RyanT2004/MEE342-Group-9/README.md

<h1 align="center">Shift Happens</h1>

<div align="center">
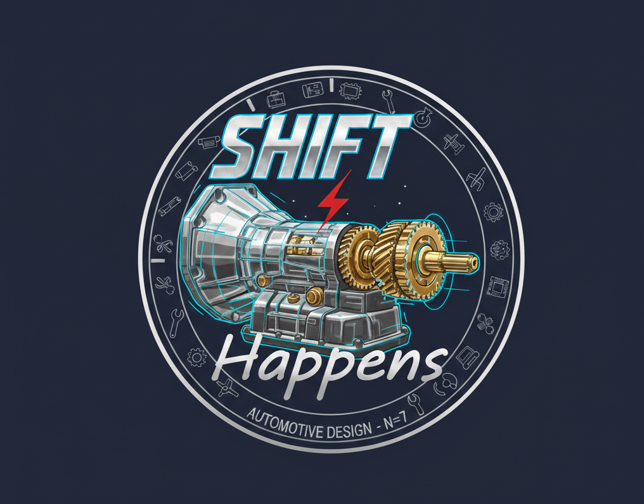
[picture p1: images/TeamLogo.png]
  
</div>

## Content
* [CAD](cad)

* [Analysis](analysis)

* [Images](images)

* [Videos](videos)

## Phase Reports
* [Phase 1](phase1/phase1.md)
* [Phase 2](phase2/phase2.md)
* [Phase 3](phase3/phase3.md)
