RyanT2004/MEE342-Group-9/images/README.md

images used in the report (diagrams, CAD screenshots, photos, etc.).
