RyanT2004/MEE342-Group-9/cad/README.md

exported CAD files in neutral formats (STEP, STL).
