RyanT2004/MEE342-Group-9/phase3/phase3video.md

Phase 3 Video Demonstrating Our Built Prototype
---
[Phase 3 Video](https://youtu.be/IrrpojLI-mE)
