RyanT2004/MEE342-Group-9/phase2/phase2video.md

Phase 2 Video Describing Our Model and Assembly
---
[Phase 2 Video](https://www.youtube.com/watch?v=oqWOlrIUnAM)
