RyanT2004/MEE342-Group-9/analysis/Calculation Images/AGMA Geometry Factor for Bending.png

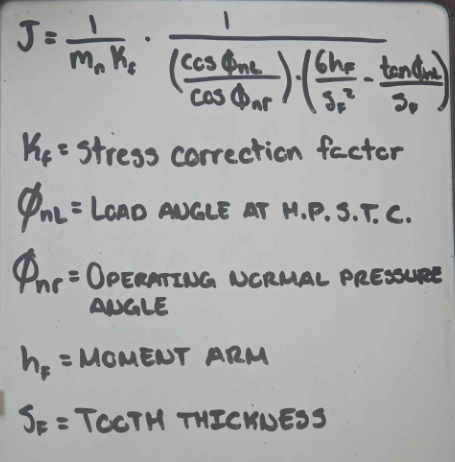
analysis/Calculation Images/AGMA Geometry Factor for Bending.png
