RyanT2004/MEE342-Group-9/analysis/Calculation Images/AGMA Standards Calculations 2.png

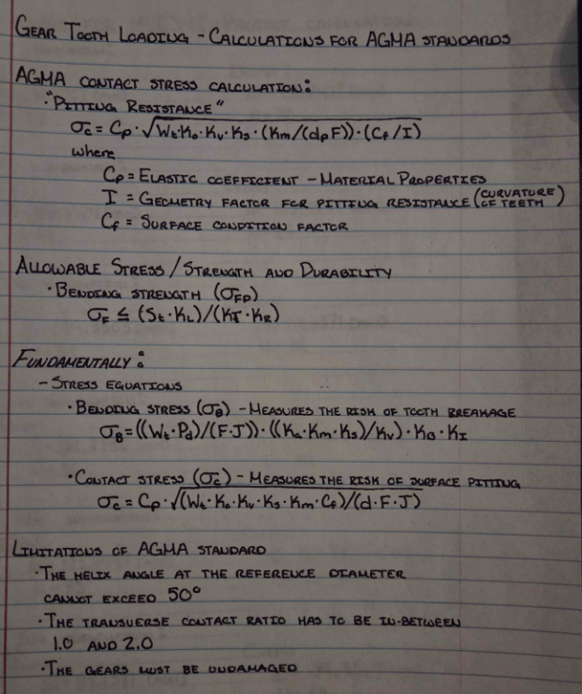
analysis/Calculation Images/AGMA Standards Calculations 2.png
