RyanT2004/MEE342-Group-9/analysis/Calculation Images/AGMA Standards Calculations.png

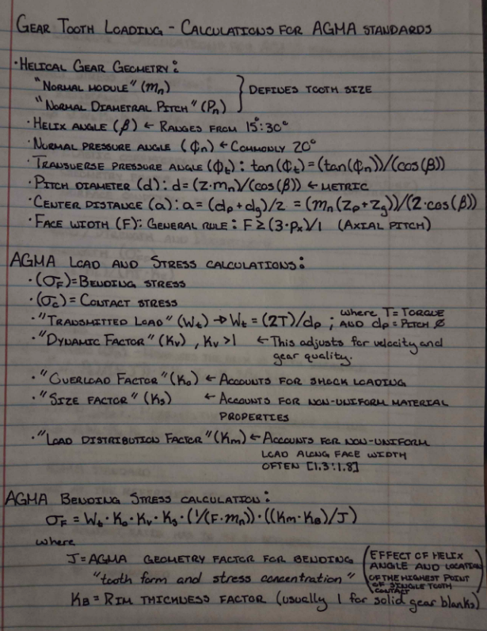
analysis/Calculation Images/AGMA Standards Calculations.png
