RyanT2004/MEE342-Group-9/analysis/Calculation Images/Gear Assumption & Explanation.png

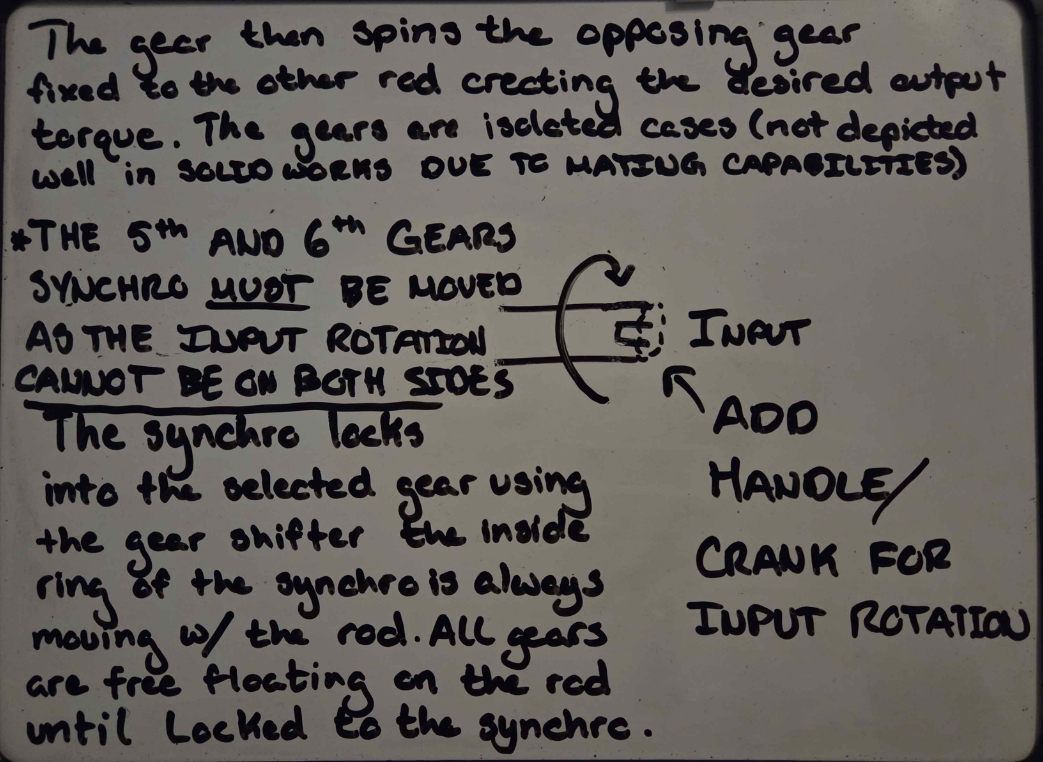
analysis/Calculation Images/Gear Assumption & Explanation.png
