RyanT2004/MEE342-Group-9/analysis/Calculation Images/Gear Ratio Calculation.png

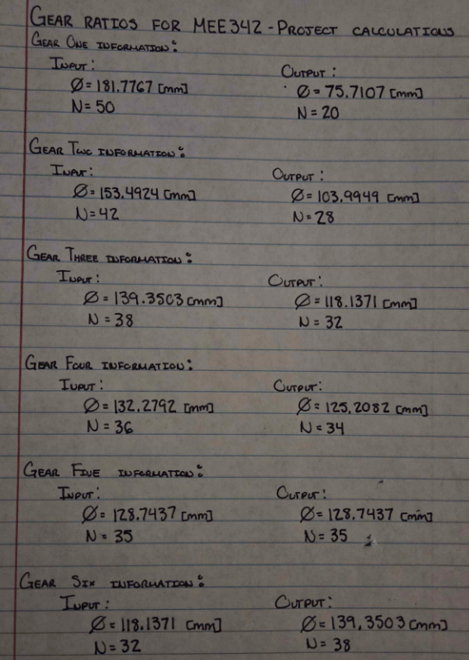
analysis/Calculation Images/Gear Ratio Calculation.png
