RyanT2004/MEE342-Group-9/analysis/Calculation Images/Torque Calculations.png

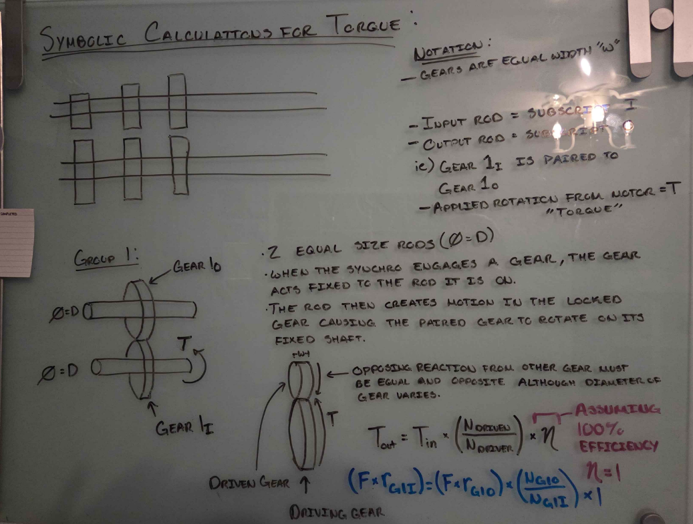
analysis/Calculation Images/Torque Calculations.png
