RyanT2004/MEE342-Group-9/analysis/Stress and Loading Image.png

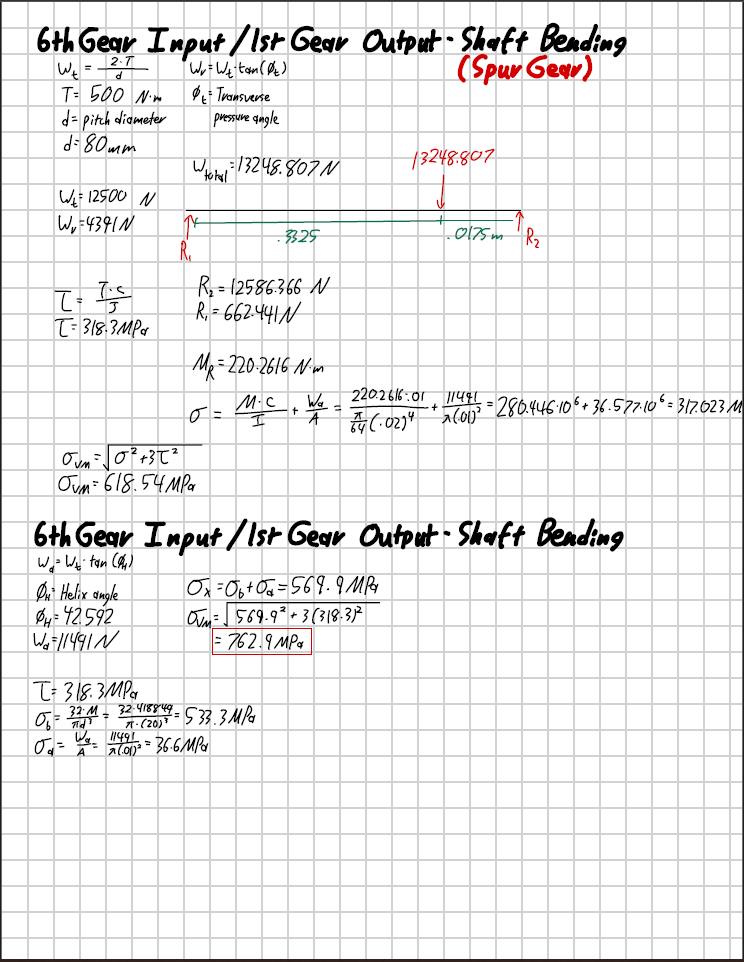
analysis/Stress and Loading Image.png
