RyanT2004/MEE342-Group-9/images/FBD.png

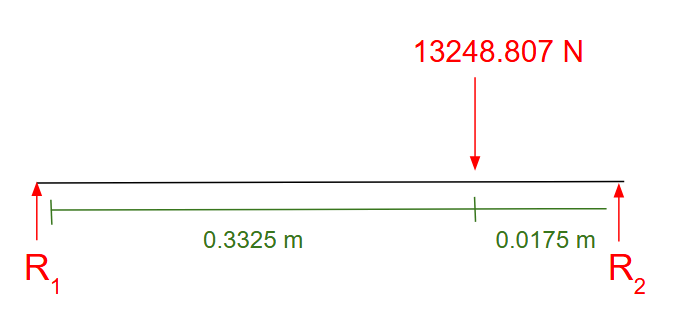
images/FBD.png
