RyanT2004/MEE342-Group-9/images/Transmission Layout.png

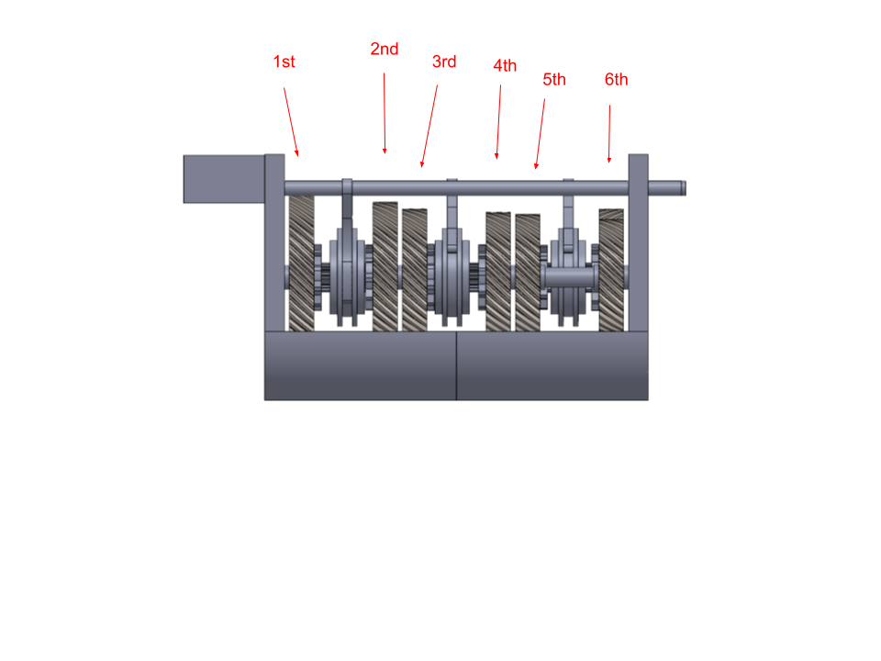
images/Transmission Layout.png
