RyanT2004/MEE342-Group-9/cad/6-Speed Manual Transmission/TransAssembly.SLDASM

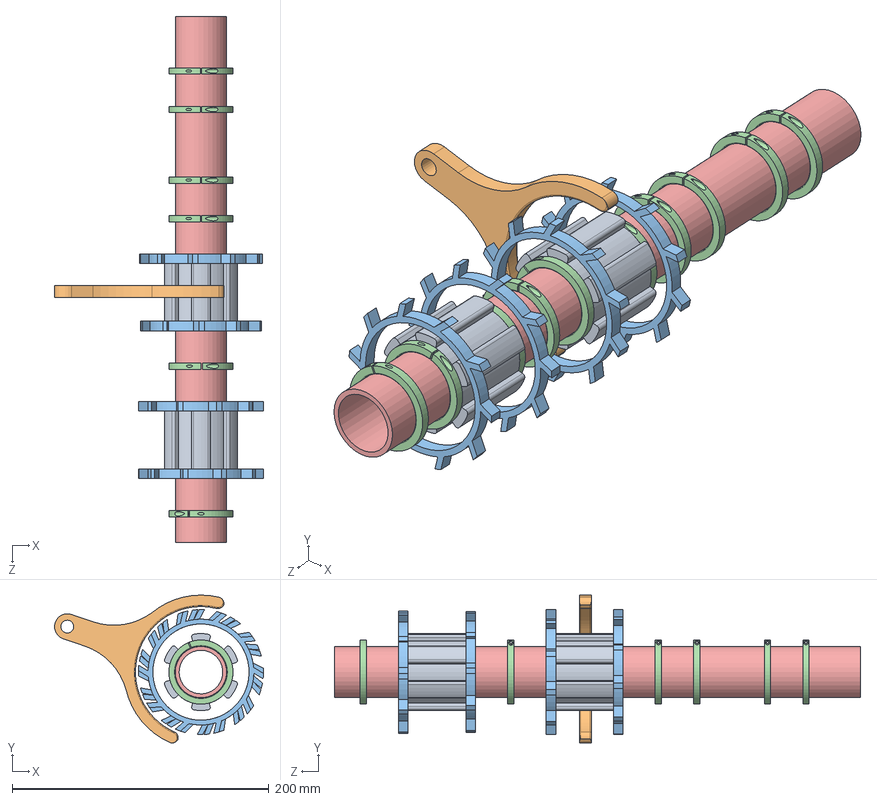
[picture p54: CAD file, 2026-05-01]
cad/6-Speed Manual Transmission/TransAssembly.SLDASM
162.9 x 115.2 x 410.0 mm
Shaft
ShaftRing x 10
gearThing x 4
Fork_Coupler
New_SynchroSleeve x 2
