RyanT2004/MEE342-Group-9/cad/6-Speed Manual Transmission/To Print/New_Full_synchro.SLDASM

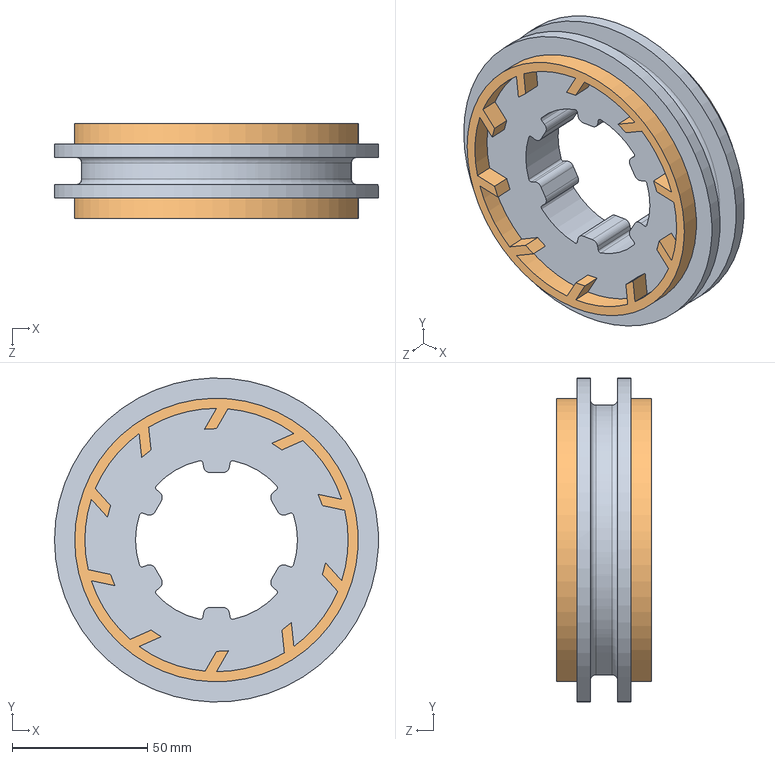
[picture p55: CAD file, 2026-05-01]
cad/6-Speed Manual Transmission/To Print/New_Full_synchro.SLDASM
120.0 x 119.9 x 35.0 mm
GearCoupler x 2
synchro_New
