RyanT2004/MEE342-Group-9/cad/6-Speed Manual Transmission/FULL_ASSEMBLY_WH.SLDASM

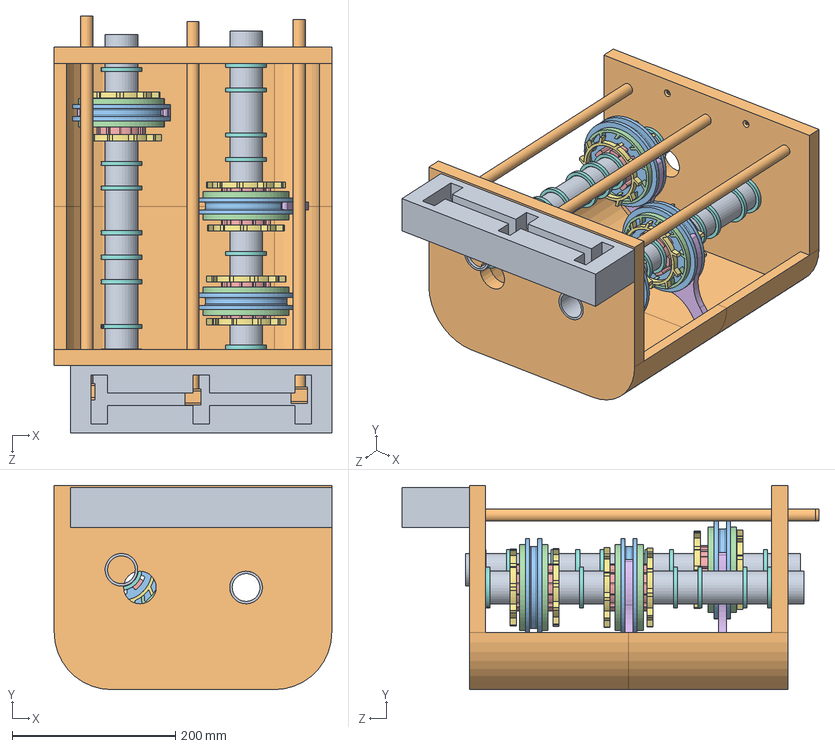
[picture p56: CAD file, 2026-05-01]
cad/6-Speed Manual Transmission/FULL_ASSEMBLY_WH.SLDASM
340.0 x 250.0 x 510.7 mm
Housing_Test x 2
Shaft x 2
ShaftRing x 20
gearThing x 6
Fork_Coupler x 2
New_SynchroSleeve x 3
GearCoupler x 6
synchro_New x 3
Shift_Cradle_Generic x 3
ShiftBox
