RyanT2004/MEE342-Group-9/cad/6-Speed Manual Transmission/Input_Assembly.SLDASM

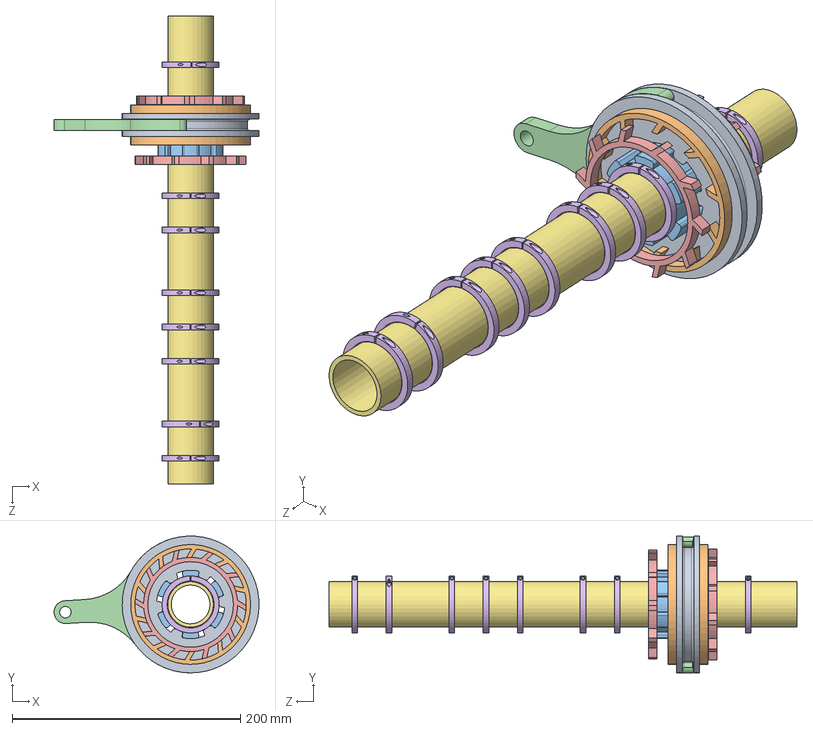
[picture p57: CAD file, 2026-05-01]
cad/6-Speed Manual Transmission/Input_Assembly.SLDASM
179.7 x 119.9 x 410.0 mm
Shaft
ShaftRing x 10
gearThing x 2
Fork_Coupler
New_SynchroSleeve
GearCoupler x 2
synchro_New
