RyanT2004/MEE342-Group-9/cad/6-Speed Manual Transmission/INPUT_gears_Updated/4th_Input_Updated.SLDPRT

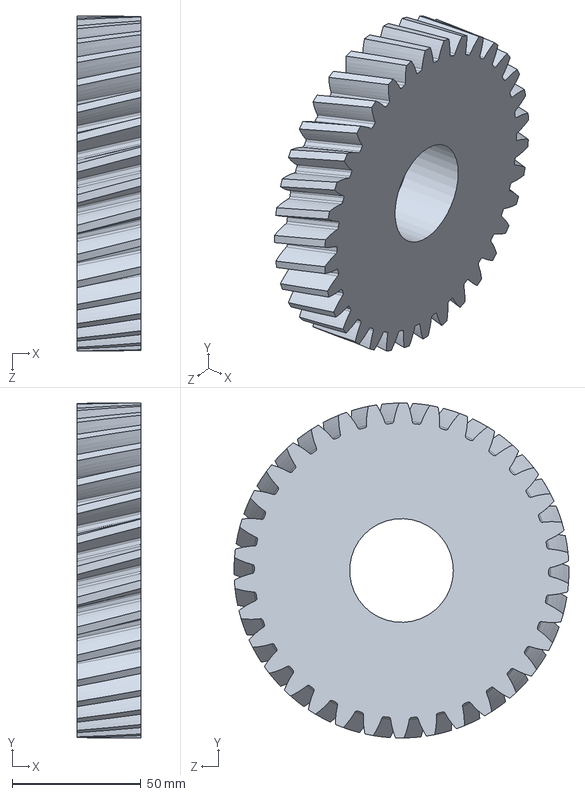
[picture p58: CAD file, 2026-05-01]
cad/6-Speed Manual Transmission/INPUT_gears_Updated/4th_Input_Updated.SLDPRT
25.0 x 130.2 x 130.2 mm
