RyanT2004/MEE342-Group-9/cad/6-Speed Manual Transmission/OUTPUT_gears_Updated/6th_Updated_Output.SLDPRT

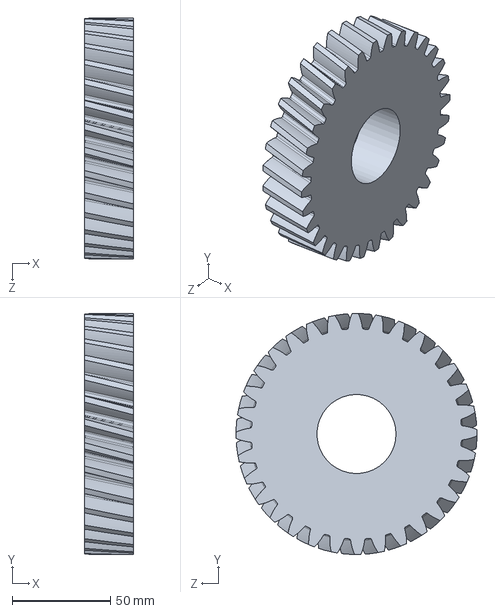
[picture p59: CAD file, 2026-05-01]
cad/6-Speed Manual Transmission/OUTPUT_gears_Updated/6th_Updated_Output.SLDPRT
25.0 x 122.9 x 122.9 mm
