RyanT2004/MEE342-Group-9/cad/6-Speed Manual Transmission/ShaftRing.SLDPRT

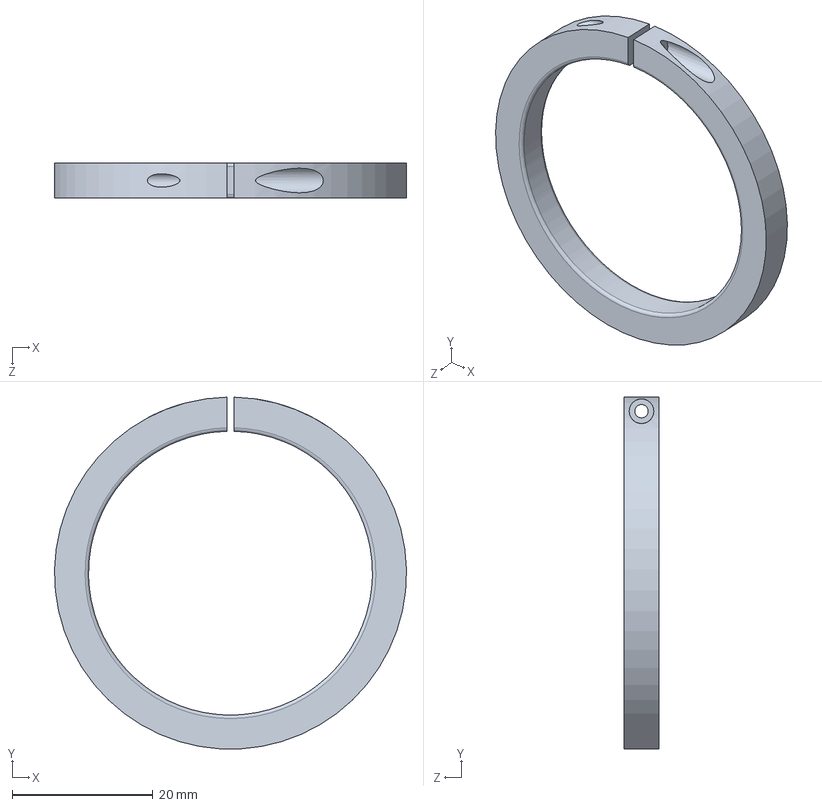
[picture p60: CAD file, 2026-05-01]
cad/6-Speed Manual Transmission/ShaftRing.SLDPRT
50.0 x 50.0 x 5.00 mm
