RyanT2004/MEE342-Group-9/cad/6-Speed Manual Transmission/Shift_Cradles/Shift_Cradle_Generic.SLDPRT

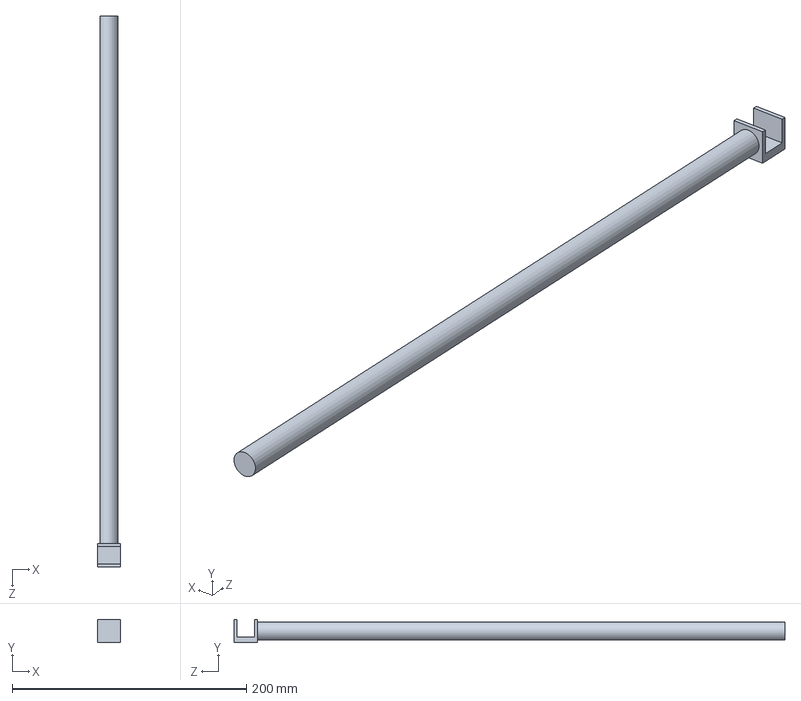
[picture p61: CAD file, 2026-05-01]
cad/6-Speed Manual Transmission/Shift_Cradles/Shift_Cradle_Generic.SLDPRT
20.0 x 20.0 x 470.0 mm
