RyanT2004/MEE342-Group-9/cad/6-Speed Manual Transmission/To Print/New_SynchroSleeve.SLDPRT

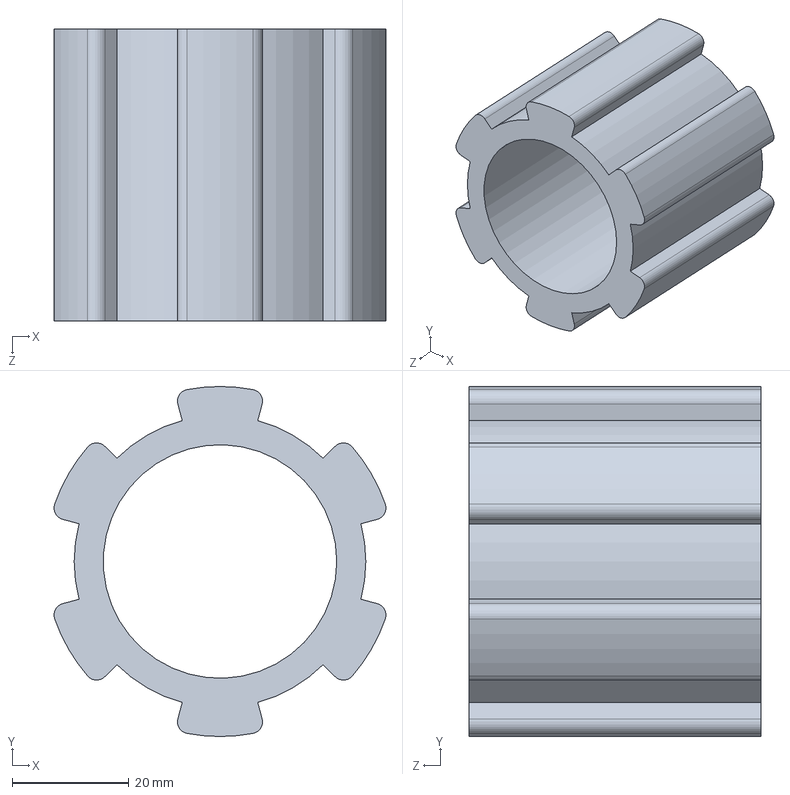
[picture p62: CAD file, 2026-05-01]
cad/6-Speed Manual Transmission/To Print/New_SynchroSleeve.SLDPRT
56.9 x 60.0 x 50.0 mm
