RyanT2004/MEE342-Group-9/cad/6-Speed Manual Transmission/Input_Gear_With_Synchro/Input_Gear6_Part_Combine.SLDPRT

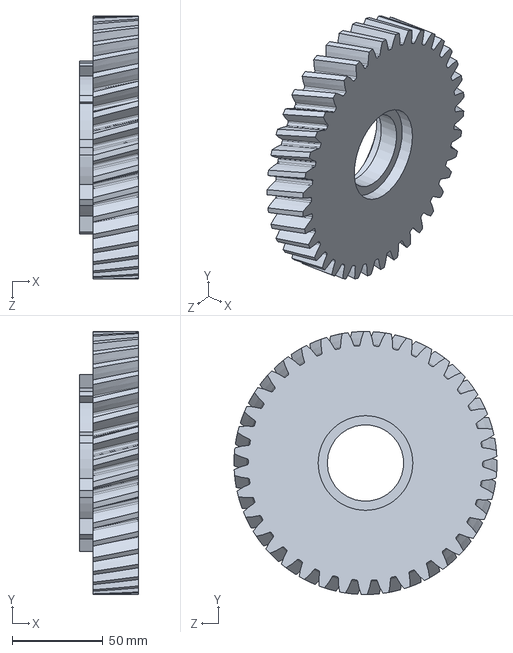
[picture p63: CAD file, 2026-05-01]
cad/6-Speed Manual Transmission/Input_Gear_With_Synchro/Input_Gear6_Part_Combine.SLDPRT
32.5 x 144.7 x 144.7 mm
