RyanT2004/MEE342-Group-9/cad/6-Speed Manual Transmission/To Print/synchro_New.SLDPRT

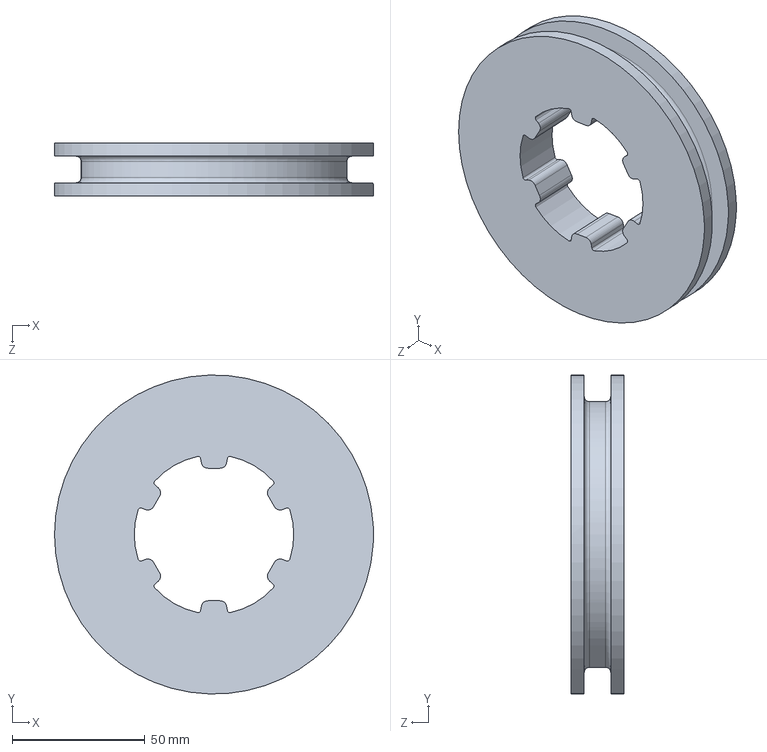
[picture p65: CAD file, 2026-05-01]
cad/6-Speed Manual Transmission/To Print/synchro_New.SLDPRT
120.0 x 119.9 x 20.0 mm
