RyanT2004/MEE342-Group-9/cad/6-Speed Manual Transmission/Input_Gear_With_Synchro/Input_Gear5_Part_Combine.SLDPRT

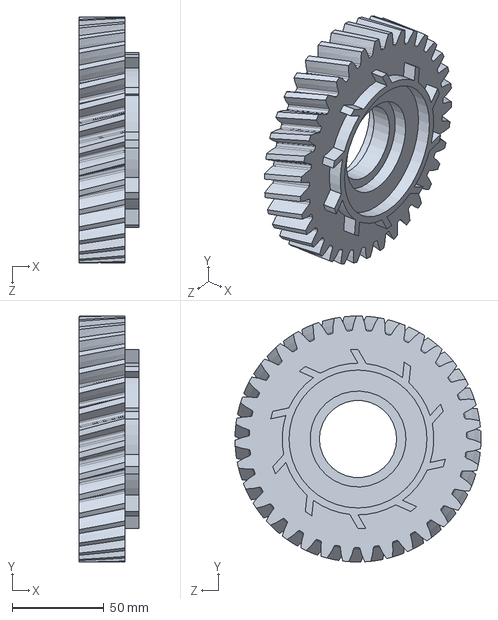
[picture p66: CAD file, 2026-05-01]
cad/6-Speed Manual Transmission/Input_Gear_With_Synchro/Input_Gear5_Part_Combine.SLDPRT
32.5 x 133.8 x 133.8 mm
