RyanT2004/MEE342-Group-9/cad/6-Speed Manual Transmission/INPUT_gears_Updated/1st_input_Updated.SLDPRT

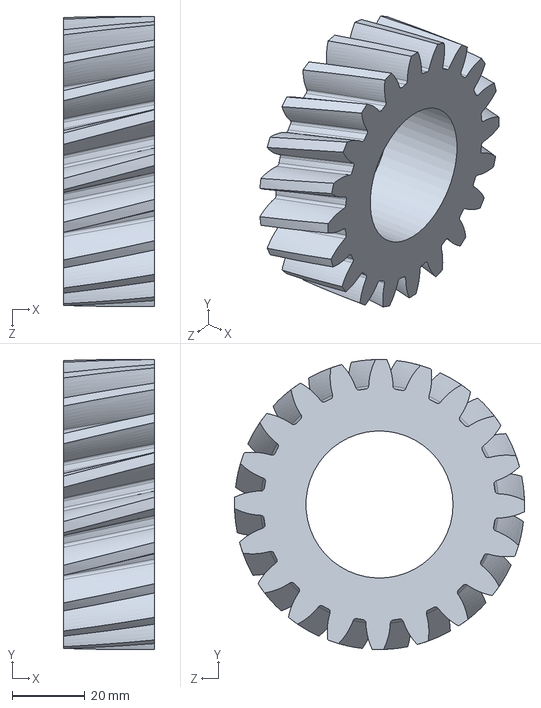
[picture p67: CAD file, 2026-05-01]
cad/6-Speed Manual Transmission/INPUT_gears_Updated/1st_input_Updated.SLDPRT
25.0 x 79.5 x 79.5 mm
