RyanT2004/MEE342-Group-9/cad/6-Speed Manual Transmission/SynchroCoupler.SLDPRT

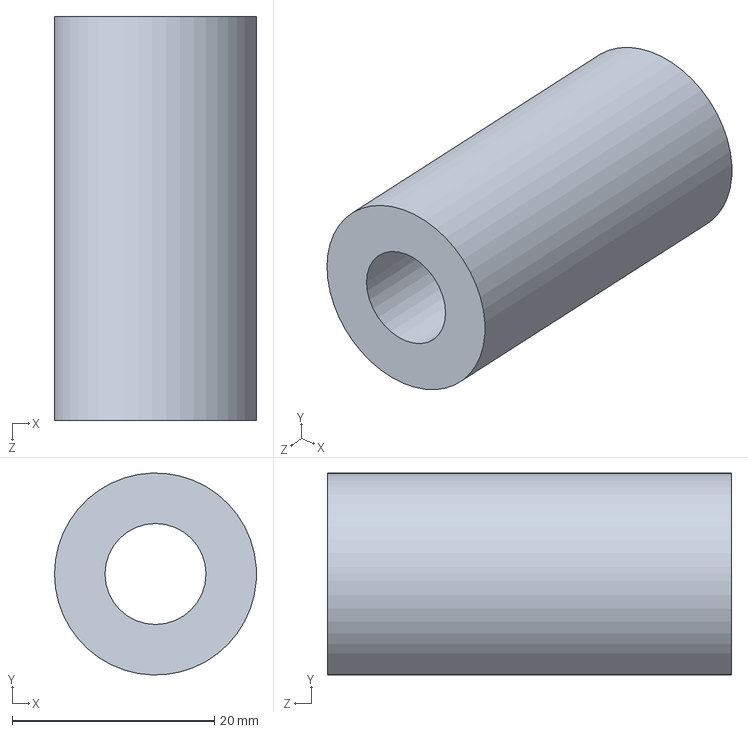
[picture p69: CAD file, 2026-05-01]
cad/6-Speed Manual Transmission/SynchroCoupler.SLDPRT
20.0 x 20.0 x 40.0 mm
