RyanT2004/MEE342-Group-9/cad/6-Speed Manual Transmission/To Print/Fork_Coupler.SLDPRT

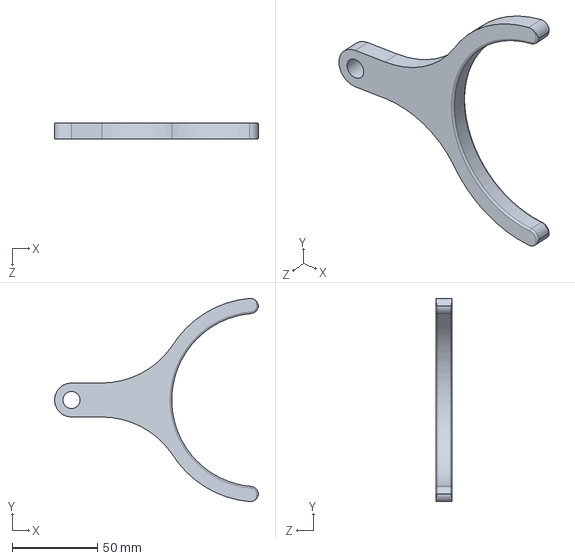
[picture p70: CAD file, 2026-05-01]
cad/6-Speed Manual Transmission/To Print/Fork_Coupler.SLDPRT
120.0 x 119.5 x 9.50 mm
