RyanT2004/MEE342-Group-9/cad/6-Speed Manual Transmission/Shaft.SLDPRT

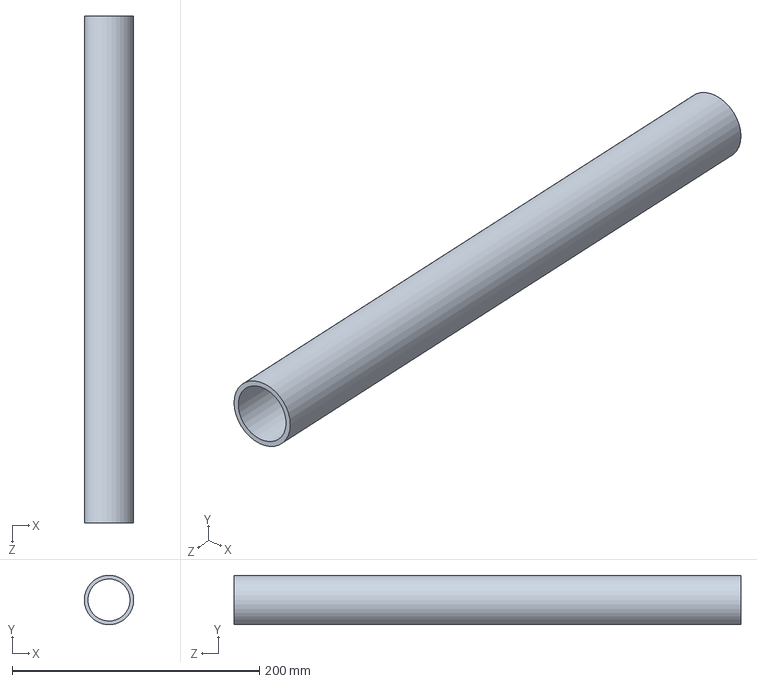
[picture p72: CAD file, 2026-05-01]
cad/6-Speed Manual Transmission/Shaft.SLDPRT
40.0 x 39.8 x 410.0 mm
