RyanT2004/MEE342-Group-9/cad/6-Speed Manual Transmission/Prop.SLDPRT

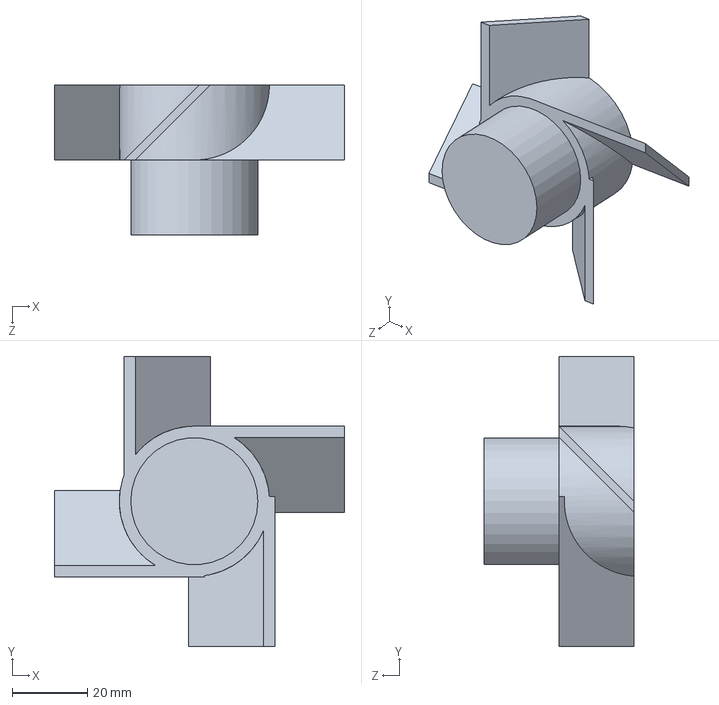
[picture p73: CAD file, 2026-05-01]
cad/6-Speed Manual Transmission/Prop.SLDPRT
77.3 x 77.3 x 40.0 mm
