RyanT2004/MEE342-Group-9/cad/6-Speed Manual Transmission/Output_Gear_With_Synchro/Output_Gear1_Part_Combine.SLDPRT

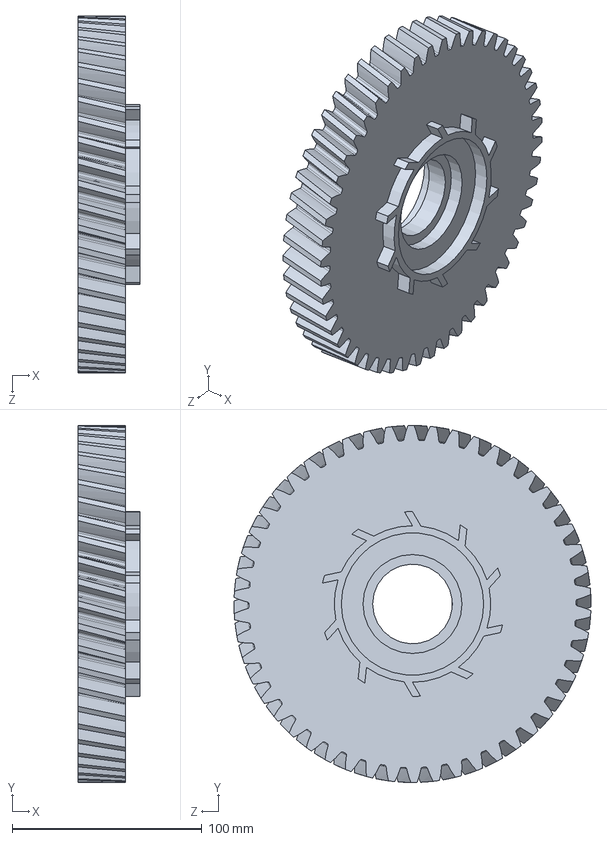
[picture p74: CAD file, 2026-05-01]
cad/6-Speed Manual Transmission/Output_Gear_With_Synchro/Output_Gear1_Part_Combine.SLDPRT
32.5 x 188.2 x 188.1 mm
