RyanT2004/MEE342-Group-9/cad/6-Speed Manual Transmission/ShiftBox.SLDPRT

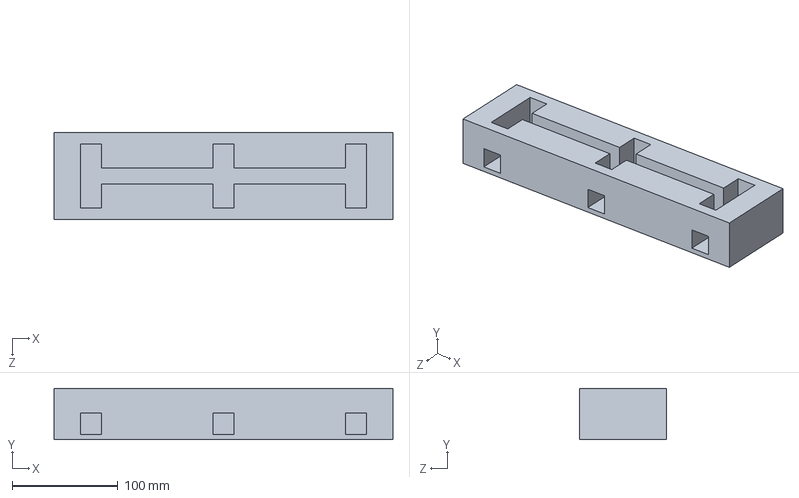
[picture p75: CAD file, 2026-05-01]
cad/6-Speed Manual Transmission/ShiftBox.SLDPRT
320.0 x 48.5 x 82.5 mm
