RyanT2004/MEE342-Group-9/cad/6-Speed Manual Transmission/Output_Gear_With_Synchro/Output_Gear2_Part_Combine.SLDPRT

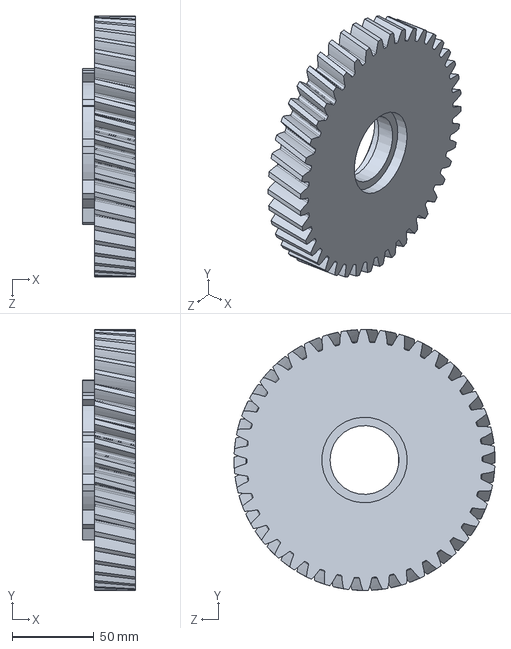
[picture p76: CAD file, 2026-05-01]
cad/6-Speed Manual Transmission/Output_Gear_With_Synchro/Output_Gear2_Part_Combine.SLDPRT
32.5 x 159.2 x 159.2 mm
