RyanT2004/MEE342-Group-9/cad/6-Speed Manual Transmission/Shifter.SLDPRT

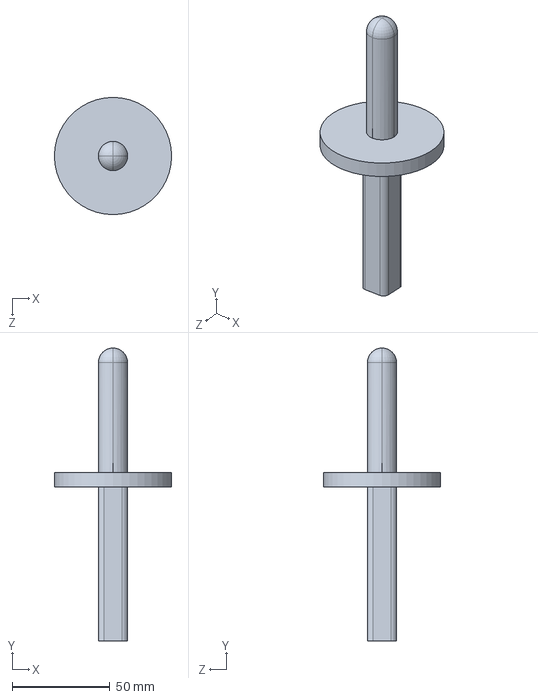
[picture p77: CAD file, 2026-05-01]
cad/6-Speed Manual Transmission/Shifter.SLDPRT
60.0 x 150.0 x 60.0 mm
