RyanT2004/MEE342-Group-9/cad/6-Speed Manual Transmission/GearCoupler.SLDPRT

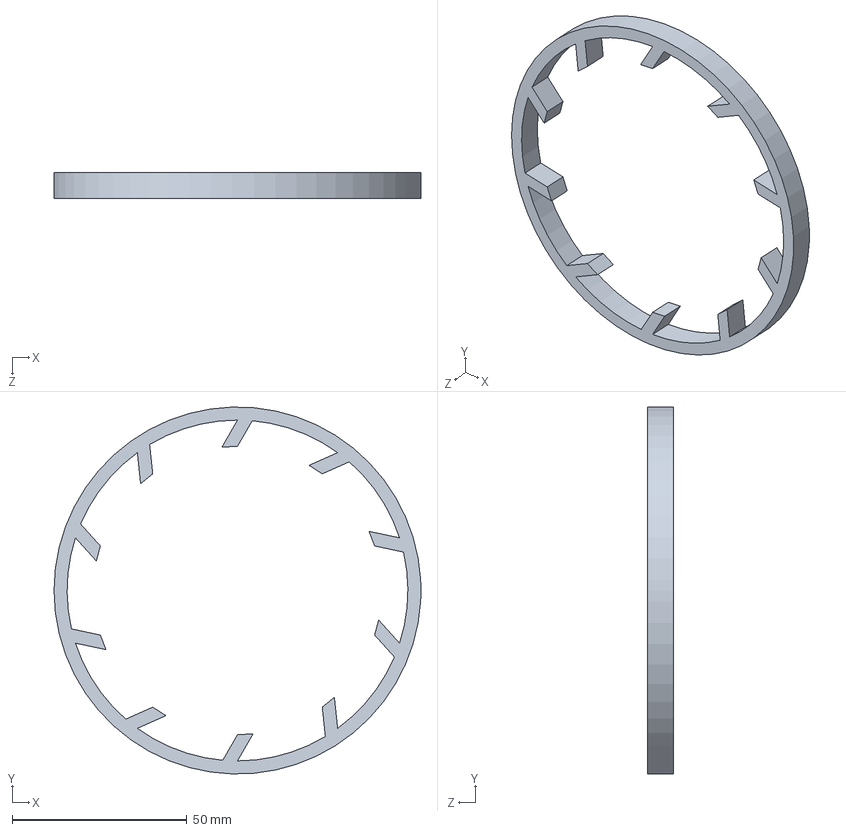
[picture p78: CAD file, 2026-05-01]
cad/6-Speed Manual Transmission/GearCoupler.SLDPRT
105.0 x 105.0 x 7.50 mm
