RyanT2004/MEE342-Group-9/cad/6-Speed Manual Transmission/Housing_Test.SLDPRT

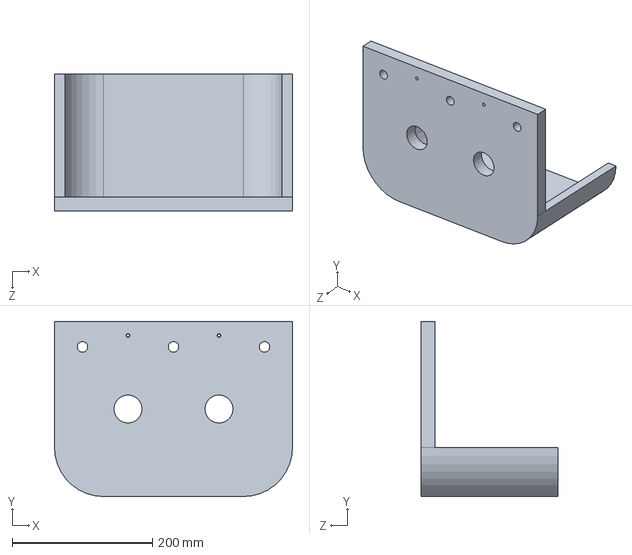
[picture p79: CAD file, 2026-05-01]
cad/6-Speed Manual Transmission/Housing_Test.SLDPRT
340.0 x 250.0 x 195.0 mm
