RyanT2004/MEE342-Group-9/cad/6-Speed Manual Transmission/gearThing.SLDPRT

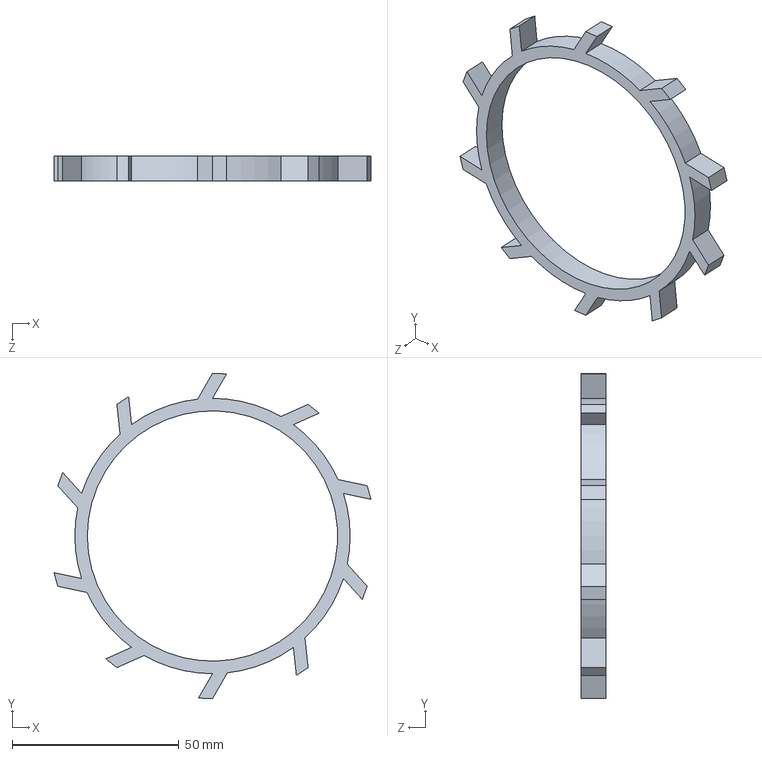
[picture p80: CAD file, 2026-05-01]
cad/6-Speed Manual Transmission/gearThing.SLDPRT
95.0 x 97.5 x 7.50 mm
