RyanT2004/MEE342-Group-9/cad/6-Speed Manual Transmission/Crank.SLDPRT

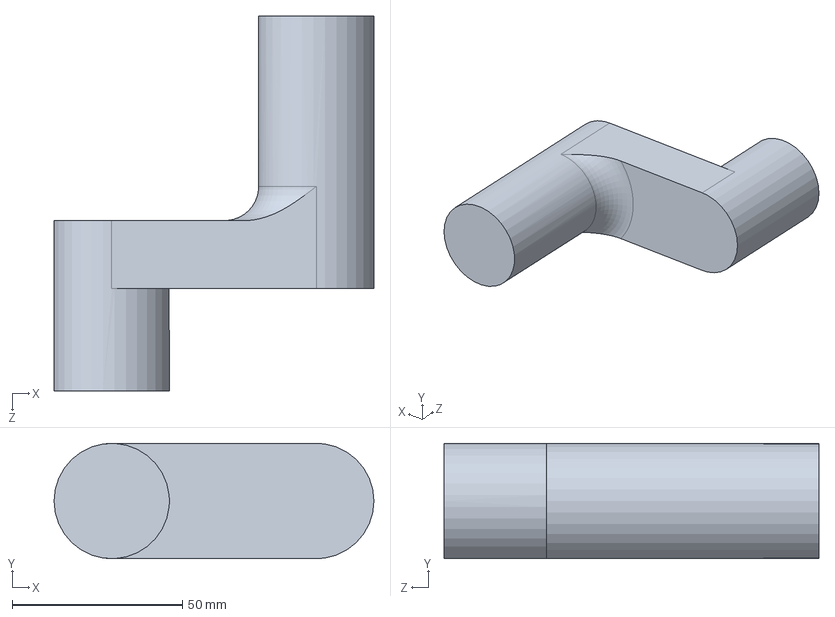
[picture p81: CAD file, 2026-05-01]
cad/6-Speed Manual Transmission/Crank.SLDPRT
93.8 x 33.8 x 110.0 mm
