RyanT2004/MEE342-Group-9/cad/6-Speed Manual Transmission/Input_Gear_With_Synchro/Input_Gear6_Assembly.SLDASM

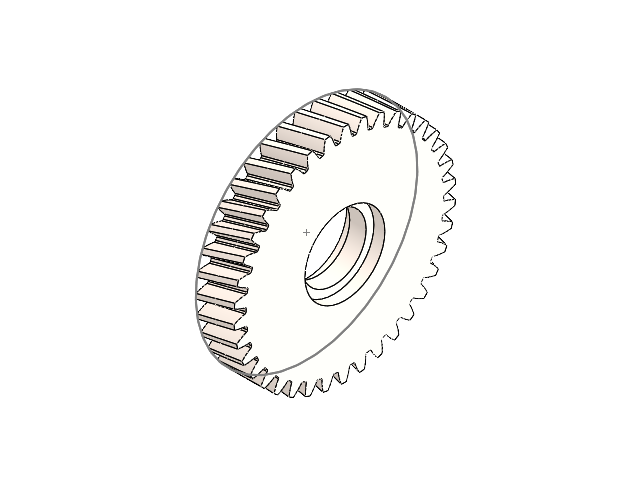
[picture p82: CAD file, 2026-05-01]
cad/6-Speed Manual Transmission/Input_Gear_With_Synchro/Input_Gear6_Assembly.SLDASM
helical gear_3_am
gearThing
