RyanT2004/MEE342-Group-9/cad/6-Speed Manual Transmission/Output_Gear_With_Synchro/Output_Gear2_Assembly.SLDASM

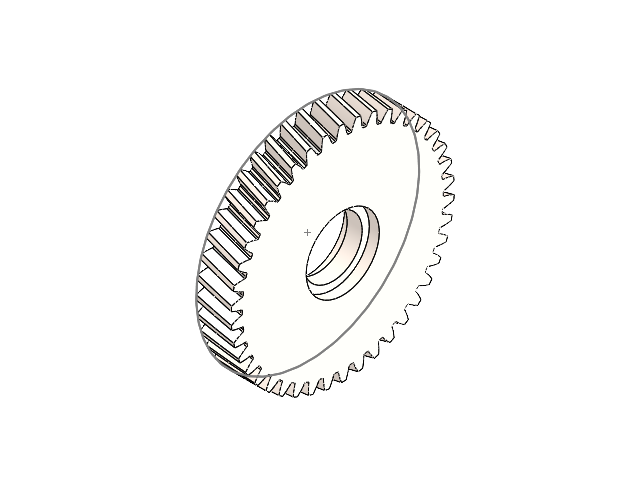
[picture p87: CAD file, 2026-05-01]
cad/6-Speed Manual Transmission/Output_Gear_With_Synchro/Output_Gear2_Assembly.SLDASM
helical gear_3_am
gearThing
