RyanT2004/MEE342-Group-9/(list of files, cad)

Other CAD files:
cad/6-Speed Manual Transmission/INPUT_gears_Updated/3rd_Input_Updated.SLDPRT
cad/6-Speed Manual Transmission/Output_Gear_With_Synchro/Output_Gear3_Part_Combine.SLDPRT
cad/6-Speed Manual Transmission/synchro.SLDPRT
cad/6-Speed Manual Transmission/Drawings/1st_Updated_Output.SLDDRW
cad/6-Speed Manual Transmission/Drawings/1st_input_Updated.SLDDRW
cad/6-Speed Manual Transmission/Drawings/6th_Input_Updated.SLDDRW
cad/6-Speed Manual Transmission/Drawings/6th_Updated_Output.SLDDRW
cad/6-Speed Manual Transmission/Drawings/Fork Coupler Drawing.SLDDRW
cad/6-Speed Manual Transmission/Drawings/Full Synchro Drawing.SLDDRW
cad/6-Speed Manual Transmission/Drawings/Gear Coupler Drawing.SLDDRW
cad/6-Speed Manual Transmission/Drawings/Housing Drawing.SLDDRW
cad/6-Speed Manual Transmission/Drawings/ShaftRing.SLDDRW
cad/6-Speed Manual Transmission/Drawings/Shift Cradle Drawing.SLDDRW
cad/6-Speed Manual Transmission/Drawings/SynchroSleeve.SLDDRW
cad/6-Speed Manual Transmission/INPUT_gears_Updated/1st_input_Updated.3mf
cad/6-Speed Manual Transmission/INPUT_gears_Updated/2nd_Input_Updated.STL
cad/6-Speed Manual Transmission/INPUT_gears_Updated/3rd_Input_Updated.STL
cad/6-Speed Manual Transmission/INPUT_gears_Updated/4th_Input_Updated.STL
cad/6-Speed Manual Transmission/Input_Gear_With_Synchro/Input_Gear5_Part_Combine.3mf
cad/6-Speed Manual Transmission/Input_Gear_With_Synchro/Input_Gear6_Part_Combine.3mf
cad/6-Speed Manual Transmission/OUTPUT_gears_Updated/5th_Updated_Output.STL
cad/6-Speed Manual Transmission/OUTPUT_gears_Updated/6th_Updated_Output.STL
cad/6-Speed Manual Transmission/Output_Gear_With_Synchro/Output_Gear1_Part_Combine.3mf
cad/6-Speed Manual Transmission/Output_Gear_With_Synchro/Output_Gear2_Part_Combine.3mf
cad/6-Speed Manual Transmission/Output_Gear_With_Synchro/Output_Gear3_Part_Combine.3mf
cad/6-Speed Manual Transmission/Output_Gear_With_Synchro/Output_Gear4_Part_Combine.3mf
