RyanT2004/MEE342-Group-9/analysis/Stress and Loading Calculation.pdf

## 6thInput/stdea Output-Shaft Bendinga

Wetan (0t) | (Spur Gear)

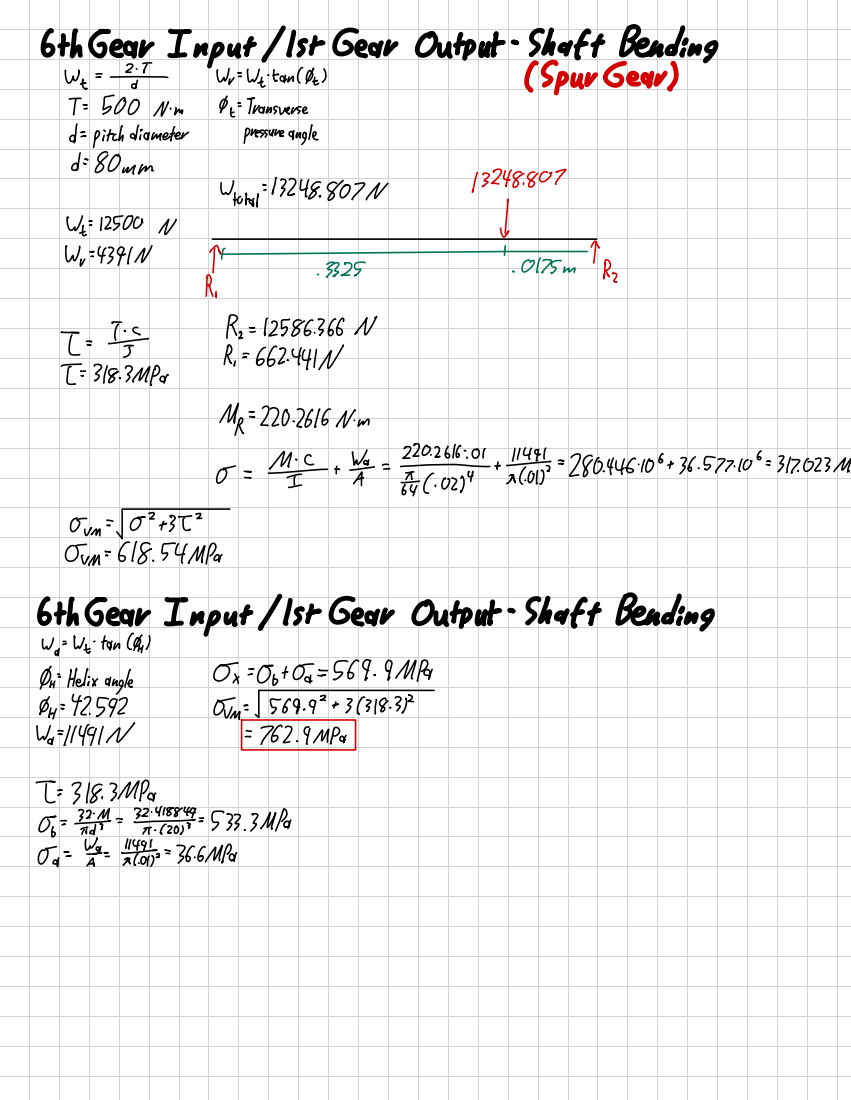
[picture p88: page 1]
#= Transverse; pitch diameter; pressure angle; Wtotal =; ORSm; 318.3MPd; 312023MPa; Cum: 618.54MPG; 6th Gear; Input/1st Gear Output-Shaft Bending W; Wh tan; DrF Helix anyle; O =+==364. PMPA; OTµ=ε6θ .⁺ 3 (318.; Waf////N; = 762.4MPA; T= 318.3MPa ==3053007=; 6MPd; 3PaU
