RyanT2004/MEE342-Group-9/(commit log)

2026-05-01 Edit 1
    [1st_Updated_Output.SLDPRT, 1st_input_Updated.SLDPRT, 2nd_Input_Updated.SLDPRT, 2nd_Updated_Output.SLDPRT, 3rd_Input_Updated.SLDPRT, 3rd_Updated_Output.SLDPRT, 4th_Input_Updated.SLDPRT, 4th_Updated_Output.SLDPRT]
2026-05-01 edit 2
    [1st_Updated_Output.SLDDRW, 1st_input_Updated.3mf, 1st_input_Updated.SLDDRW, 1st_input_Updated.SLDPRT, 2nd_Input_Updated.SLDPRT, 2nd_Input_Updated.STL, 3rd_Input_Updated.SLDPRT, 3rd_Input_Updated.STL]
