RyanT2004/MEE342-Group-9/images/Step 1.JPG

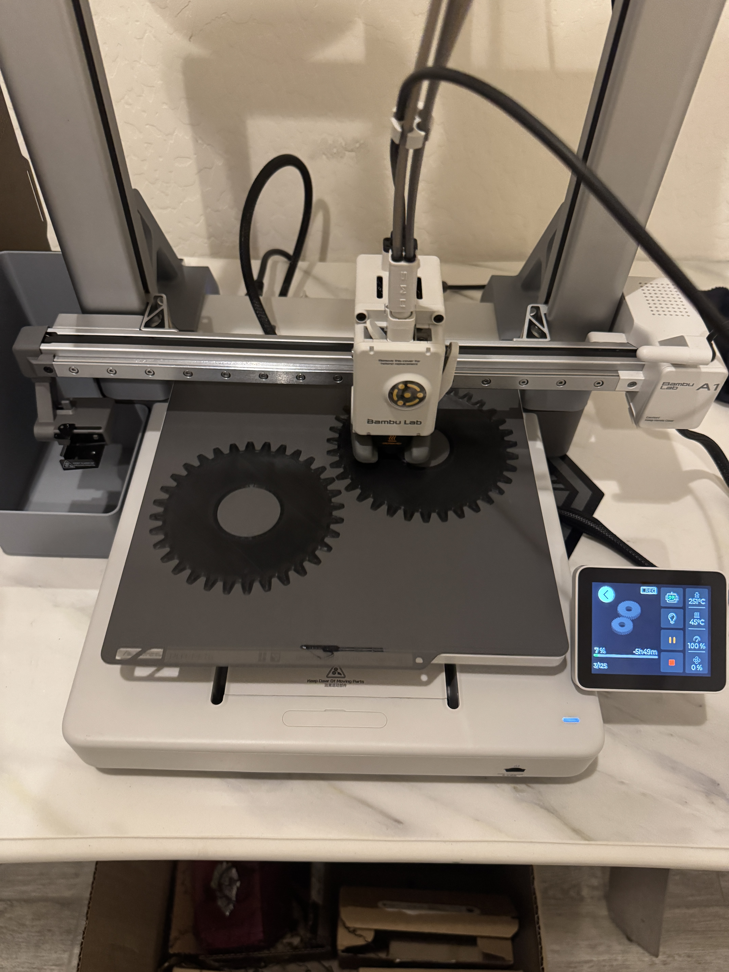
[picture p2: images/Step 1.JPG]
images/Step 1.JPG
